icycaptain/nokk/(commit log)

2025-10-04 Schaltplan aktualisiert und weisser Hintergrund
2025-10-09 RS485 pin
2025-10-09 Modbus Motorregelung Beine
2025-10-09 Motor Speed fix
2025-11-09 Motor funktioniert mit Getriebe
2026-01-04 PS2X controller replaces Bluetooth, update doc,
    [Controller.ino]
2026-08-09 Remove yaw limit
